Riigs/protopaja2018/(list of files, drawings)

Other design files:
kaaviot/Ensto_kytkentäkaavio.dch
kaaviot/Ensto_piirilevy_kytkentäkaavio.dch
kaaviot/Ensto_piirilevy_V2_valmis.dip
