Riigs/protopaja2018/(commit log)

2018-06-27 Projektitiedoston rakenteen muutos
    Loin lib kansion, johon siirsin kaikki moduulit. Lisäksi pymakr.conf tiedosto luotu ja muokattu projektin reittiä. Luotu mittaus tiedosto, jossa mm. adc mittausfunktio, jota kuormien olio kutsuu.
2018-07-11 Update main.py
    Laitettu ADC olion määrittely Main funktioon.
2018-07-11 adc:n määrittely siirretty mittaus.py:hyn
2018-07-13 Korjattu bugeja eilisestä koodista
    [main.py]
2018-07-17 Output-pinnejä taas vaihdettu P2 on käytössä (LED)
2018-07-17 Keskiarvoistus vähennetty 2000->100 arvoa. Itsetehty ADC tarkempi?
2018-07-17 ledin vilkkumista muutettu, vähän siistitty koodia
2018-07-18 Lisätty: nettiin yhdistys, kulutusten seuranta ja niiden "lataus" nettiin ja resettaus
    ei vielä lataa nettiin, funktio jonka pitäisi tehdä niin luotu
    [main.py]
2018-07-25 Tunnittainen kulutusten resettaus
    Ei vielä testattu, myös poistettu turhia muuttujia yms
    [main.py]
2018-07-25 Testattu, yksi bugi korjattu, ei testattu vielä uudelleen
    [main.py]
2018-07-26 Kommentoitu muutama print-komento pois
2018-07-26 Uusi tehonrajoitus toteutettu, joitakin vanhoja print-komentoja kommentoitu pois
    Uusi tehonrajoitus: tunnin ensimmäisten 30 minuutin aikana tehoa EI rajoiteta. Sen sijaan vain varmistetaan, että tuona aikana käytetään enintään 50% kaikesta mahdollisesta tunnin aikana käytettävästä energiasta.
    Kun kello ylittää 30 min, siirrytään tehonrajoittamiseen. Maksimiteho rajoittaa tehoa. Joka viides sekunti lasketaan uusi maksimiteho, käyttäen hyväksi jäljellä olevaa energiaa (maksimi - nykyinen kulutus) ja jäljellä olevaa aikaa (60 min - nykyinen aika).
    Also joitakin vanhoja print-komentoja kommentoitu pois, jotta outputtia olisi helpompi lukea.
2018-07-26 Lisätty funktio, joka hakee databasesta kuukauden suurimman tuntitehon ja milloin se on ollut
    Myös apufunktio, joka selvittää, mikä on kysytyn kuukauden viimeinen päivä
2018-08-01 Ulkoisen AD-muuntimen käytön mahdollistaminen
    -sensoripinnit muutettu commandbiteiksi, joilla kuormaa vastaava kanava valitaan
    -uusia funktioita näihin liittyen, vanhoja muutettu
2018-08-01 Sensoripinnit muutettu commandbiteiksi
2018-08-01 Sensoripinni muutettu commandbiteiksi
2018-08-06 Otetaan inputiksi sensorin maksimivirta
2018-08-06 Annetaan inputeiksi adcReadille sensorin maksimivirta
2018-08-06 Pieni bugi korjattu (unohdettu vöhentää 1)
    [main.py]
2018-08-10 Kontrollimuuttujat päivitetään omassa threadissa, jotta se ei hidasta ohjelmaa
2018-08-14 No more memory errorrrrrr
    [main.py]
